0xrphl/iot-vehicle-telemetry/aliexpress materials.txt

===============================================================================
  📦 AliExpress Component Sourcing — Electric Delta-Kart IoT Telemetry
  📍 Pereira, Risaralda, Colombia (Single-Vehicle Build)
  💰 Updated: November 2026
===============================================================================

1. 📱 LilyGO T-SIM7672G V1.1 — ESP32-S3 + 4G LTE Cat-1 + Multi-GNSS + 18650 + SD
   🔗 URL:   https://aliexpress.com/item/1005007058444056.html
   💲 Price: $45.00 USD
   📋 Specs: ESP32-S3-WROOM-1 MCN16R8 (16MB Flash / 8MB PSRAM), SIM7672G 4G LTE
             + Multi-GNSS (GPS/GLONASS/Galileo/BeiDou), 18650 holder, MicroSD slot

2. 🔄 Bosch BMI160 — 6-DOF Gyroscope + Accelerometer + Die Temp Module
   🔗 URL:   https://www.aliexpress.us/item/3256809462979321.html
   💲 Price: $2.50 USD
   📋 Specs: Wire0 I2C (SDA=GPIO 1, SCL=GPIO 2 @ 400kHz, 0x68), 30Hz attitude fusion

3. ⏱️ Maxim DS3231SN/MZ + AT24C32 — Precision TCXO RTC + EEPROM + CR2032
   🔗 URL:   https://www.aliexpress.com/w/wholesale-DS3231-AT24C32-module.html
   💲 Price: $2.20 USD
   📋 Specs: Wire1 I2C (SDA=GPIO 42, SCL=GPIO 41 @ 400kHz, 0x68/0x57), zero collision

4. 🔋 18650 Li-Ion Cell (3400mAh 3.7V/4.2V)
   💲 Price: $3.50 USD
   📋 Specs: Monitored via GPIO 4 x2 ADC divider in raw V & mV (strictly no %)

5. ☀️ Mono/Poly Solar Panel (5V–6V 150mA)
   🔗 URL:   https://es.aliexpress.com/item/1005005825496564.html
   💲 Price: $5.49 USD
   📋 Specs: Monitored via GPIO 5 x2 ADC divider in raw mV & V

6. 💾 32 GB MicroSDHC Card (Class 10 SPI Blackbox)
   💲 Price: $5.80 USD
   📋 Specs: SPI (CS=13, MOSI=14, SCK=21, MISO=47), 5Hz CSV logs (>11,000 hrs)

7. 📶 Movistar Colombia 4G Nano-SIM (220 MB Plan) + Dupont Harness
   💲 Price: $5.01 USD
   📋 Specs: APN internet.movistar.com.co (>650 hrs active driving sync to Supabase)

===============================================================================
  💰 SINGLE-VEHICLE TOTAL: $69.50 USD
===============================================================================
