0xrphl/iot-vehicle-telemetry/dashboard_server/server.py

import http.server
import socketserver
import os
import sys

PORT = 8080
DIRECTORY = os.path.dirname(os.path.abspath(__file__))

class Handler(http.server.SimpleHTTPRequestHandler):
    def __init__(self, *args, **kwargs):
        super().__init__(*args, directory=DIRECTORY, **kwargs)

    def end_headers(self):
        self.send_header('Cache-Control', 'no-cache, no-store, must-revalidate')
        self.send_header('Pragma', 'no-cache')
        self.send_header('Expires', '0')
        super().end_headers()

def run():
    with socketserver.TCPServer(("", PORT), Handler) as httpd:
        print(f"[Web Dashboard] Serving at http://0.0.0.0:{PORT}")
        print(f"[Web Dashboard] Local Network URL: http://localhost:{PORT}")
        try:
            httpd.serve_forever()
        except KeyboardInterrupt:
            print("\nShutting down web server.")

if __name__ == '__main__':
    run()
